PaulRB/Wemos-Weather-Station/README.md

# Wemos-Weather-Station
Outdoor Weather Station with Wind Speed, direction & Rainfall sensors
UPDATE: now with Lux/light level sensor
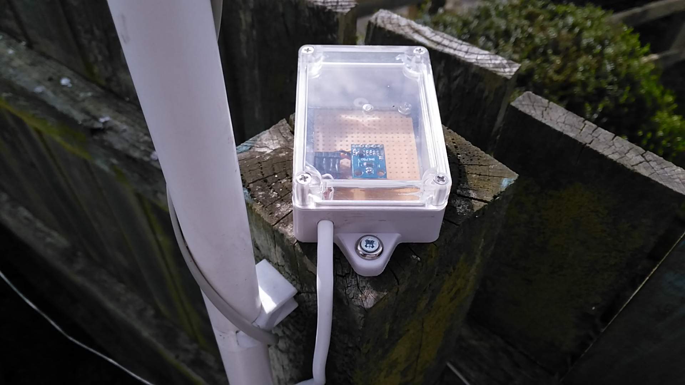
[picture p1: IMG_20170402_141529.jpg]

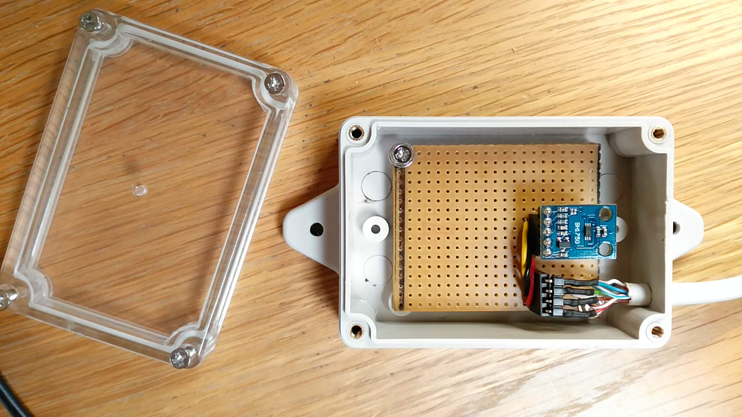
[picture p2: IMG_20170402_122711.jpg]

UPDATE: now with Wemos Mini Pro + external antenna
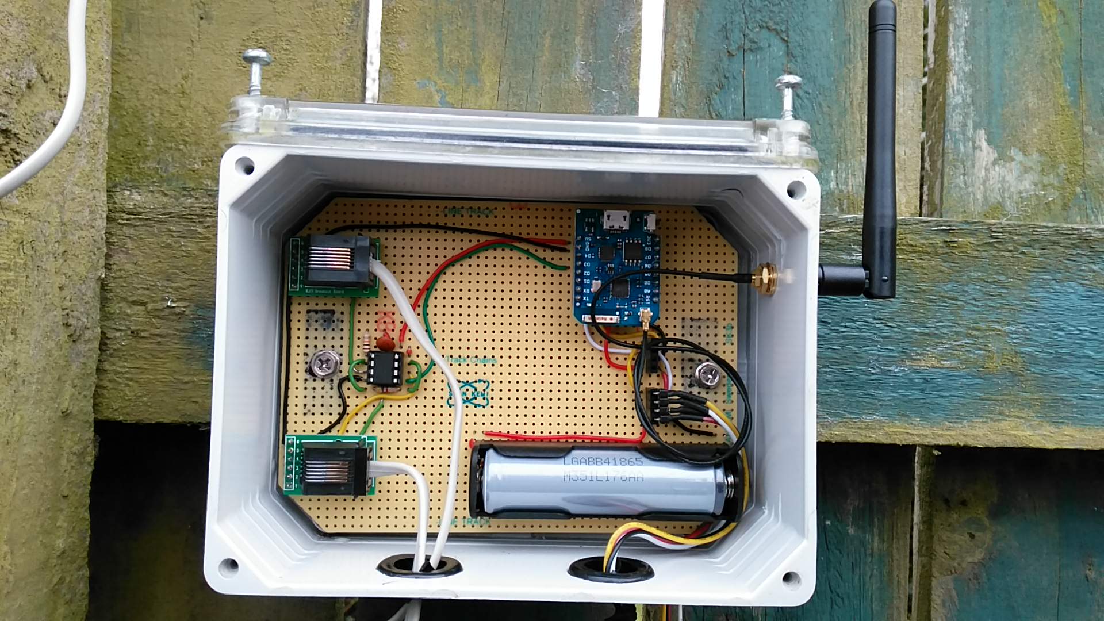
[picture p3: IMG_20170226_153004.jpg]

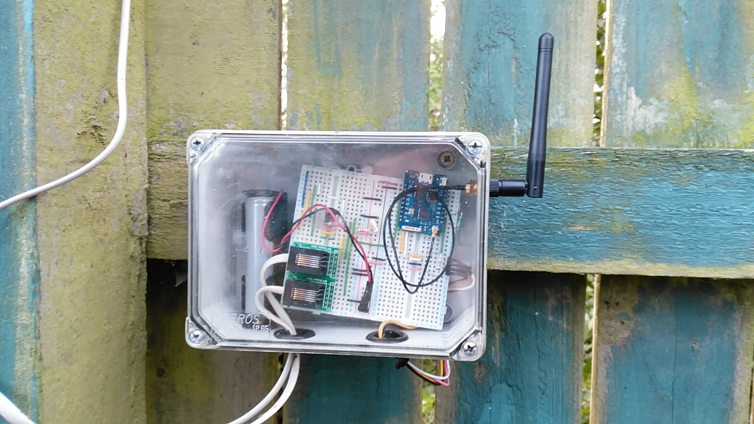
[picture p4: IMG_20161112_151442.jpg]

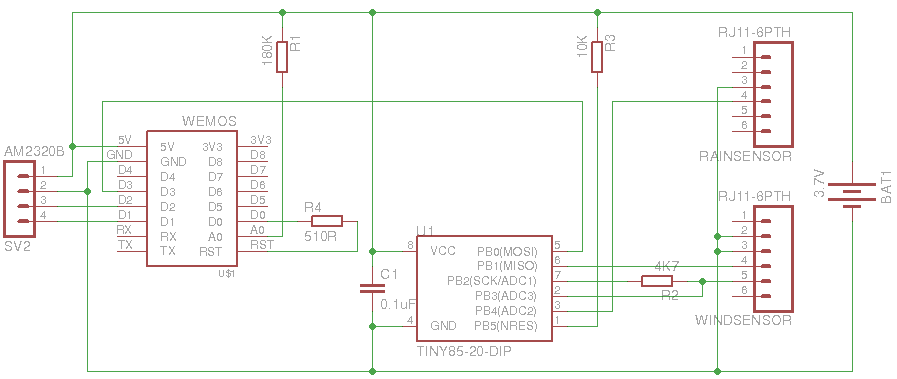
[picture p5: OutdoorSensorV3.png]

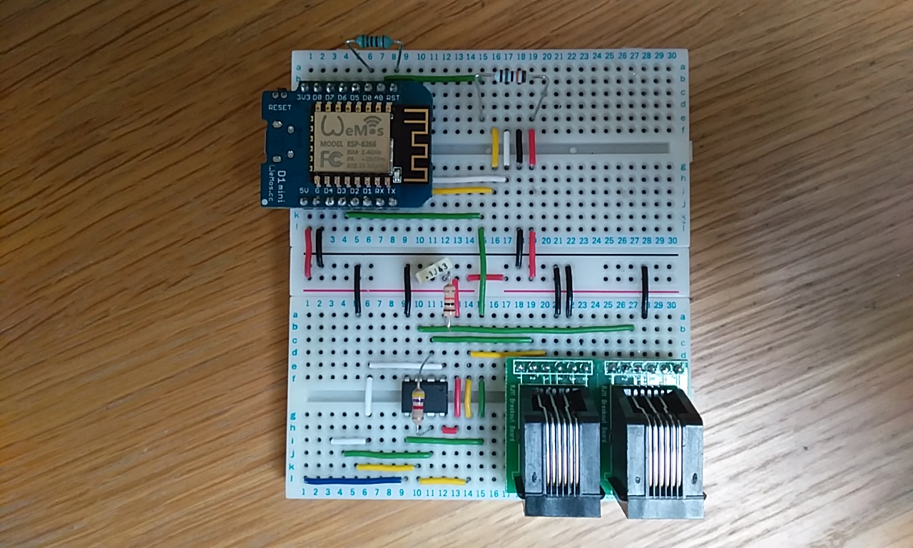
[picture p6: IMG_20160711_180757.jpg]

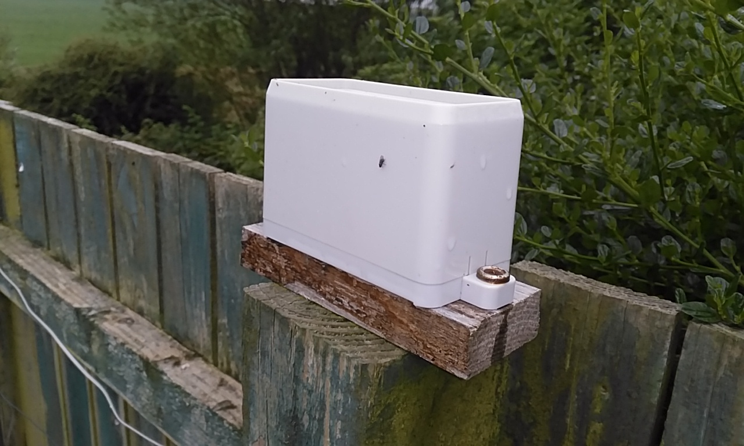
[picture p7: IMG_20160827_164953.jpg]

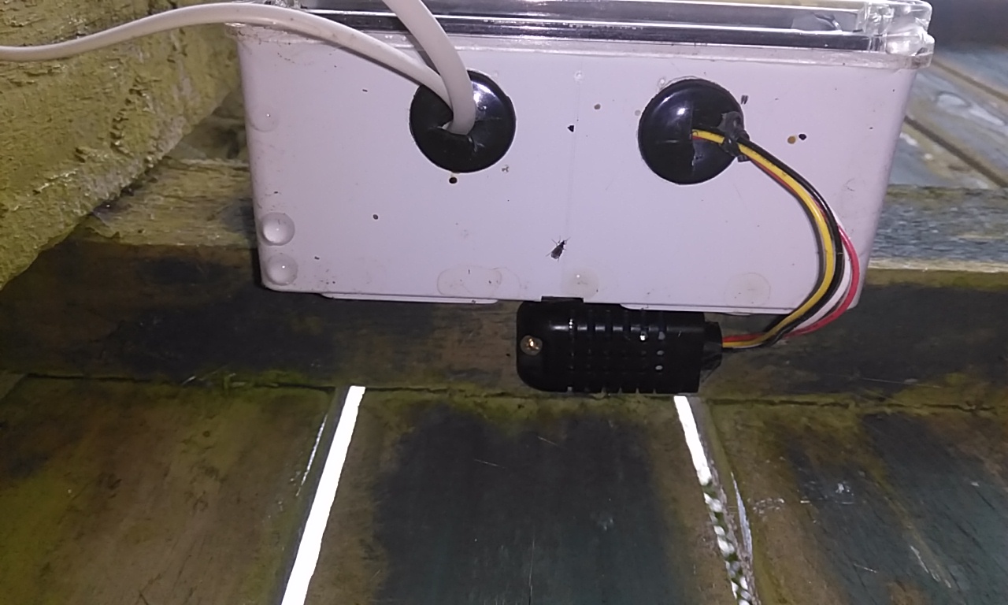
[picture p8: IMG_20160827_165017.jpg]

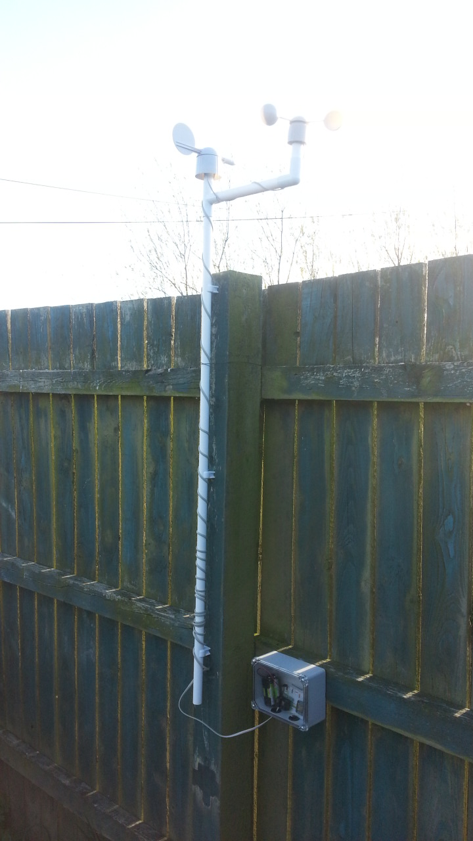
[picture p9: 20160430_181712.jpg]

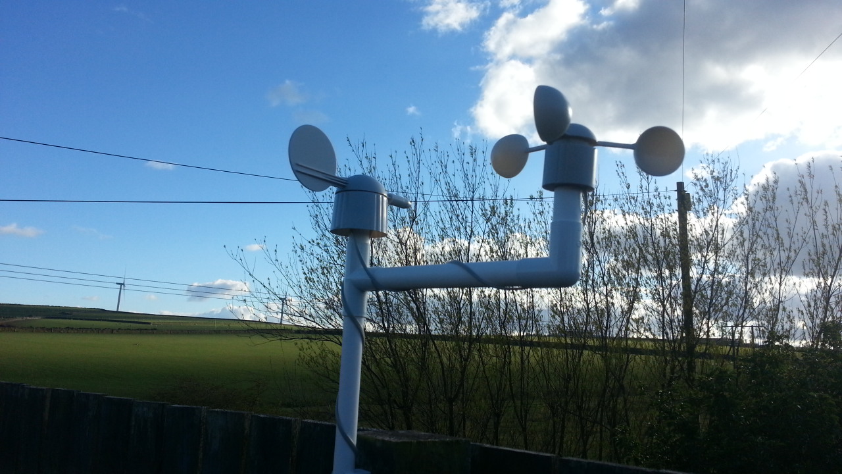
[picture p10: 20160430_181659.jpg]
