PaulRB/Wemos-Weather-Station/IMG_20160827_165125.jpg

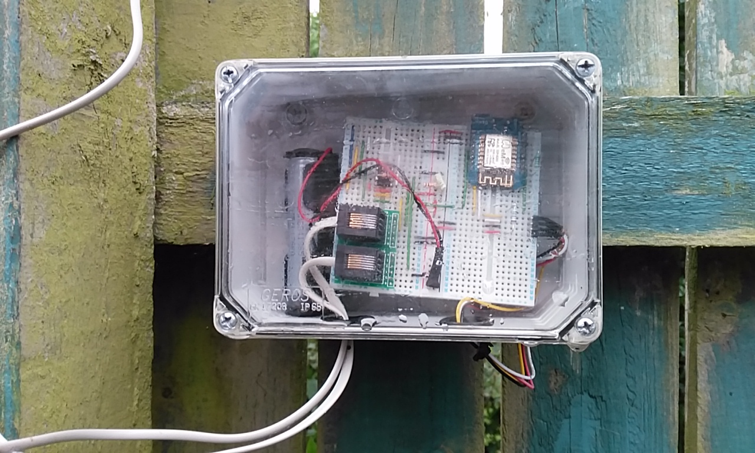
IMG_20160827_165125.jpg
