PaulRB/Wemos-Weather-Station/(threads)

Thread 2 (2018-08-12):

Question about voltage measurement

beicnet, 2018-08-12:
What is it represents?

`double battLevelNow = analogRead(BATT_LEVEL) / 209.66; // assumes external 180K resistor`

**`209.66`** Measured resistor value by multimeter or?

PaulRB, 2018-09-01:
It's a value calculated to give a known output voltage in the above formula, compared to my (inexpensive) multimeter. You can adjust the value for you own circuit if required.

beicnet, 2018-09-01:
Okay @PaulRB so how did you calculate it and by what formula any explanation?!

Thank you

PaulRB, 2018-09-01:
I calculated it with basic School maths!

Connect a voltage to the analog pin (via the 180K resistor). Measure that voltage with your multimeter, let's say that's 3.27V for example. Take the raw analogRead() value, let's say that's 686. Divide one by the other, you get 209.66.

Closed 2018-12-12.

Thread 3 (2020-04-24):

Max freq/speed of anemometer pulse detector?

colwilliamsnz, 2020-04-24:
Hi Paul, I have implemented a station using your ideas around the ATTiny85 slave device and found that the maximum anemometer frequency that can be decoded in my prototype is ~25Hz (roughly 90kph, tested using a signal generator). I wonder if you ran into this limitation at all? Struggling to make sense of it.

If I remove the sleep code I can decode beyond 60hz just fine. The current draw is 200~300uA extra in this mode so its not a huge deal, more a curiosity :)

Any clues or insight?

Thanks for sharing, its a great little project that has keep my mind nicely occupied during lockdown ;)

PaulRB, 2020-05-11:
Hi, sorry for the delay in replying!

I never tested it to that extent. I estimated that it should be able to deal with higher frequencies than that. I have never noticed the readings maxing out in practice, either on average or max gust speeds. I live in a windy place, but 90Kph is rare (thank goodness), so it could be under-reading without me realising its happening. I don't even know for sure if my cheap plastic anemometer can deal with those speeds.

Plus, where my anemometer is sited, my neighbour's bushes have grown significantly over the last 2 or 3 years and are now shadowing the sensor. I need to move it, but the only other sites are so far from the house that the WiFi won't reach.

Because of this, I am re-designing the circuit. The replacement will be an atmega328 and will use an rfm95 LoRa transmitter. This should enable me to get much greater range and lower battery consumption. The prototype is powered by 3 x AAA NiMh cells and draws 15uA when not transmitting, and even when transmitting, far lower current than WiFi. I have not implemented wind direction or rain sensing for the prototype yet, so that current may go up a little.

I don't have a signal generator to test with, but I can soon rig up an Arduino Nano or something to generate test signals for the new circuit. I estimate max frequency of 50Hz should cover the highest winds we see here.

colwilliamsnz, 2020-05-11:
Thanks for the update. I found the issue to be because I’d refactored the code so much (I switched it to I2C instead of serial because I couldn’t get the single wire serial working) and had the anemometer sensor bit way down in the loop…moving back to the top gets it to 60Hz+ which is plenty (I live in New Zealand windiest city but we'll fly off the hill if it gets to that ;)

It’s an inspired little idea that I’d keen to push further. I started out playing with LoRa and then discovered ESP32 and decided an all in one approach was best…power consumption its still the beast to tame and I’m thinking about starting the quest again just to see if I can eek out some more savings but using your overall slave approach for wind & rain.

Thanks again for inspiring!

PaulRB, 2020-05-12:
> I switched it to I2C instead of serial because I couldn’t get the single wire serial working
It took me a long time to get it working. Guess what? I switched to serial when I couldn't get i2c to work! That was my original plan, but I had problems with the master & slave getting out of sync, corrupting the data. This didn't happen immediately but occurred from a few minutes to several hours after startup, so was difficult to debug. I looked into using 1-wire Comms also (as used by ds18b20 sensors for example) but failed to get that working either, so invented my own crude "1-wire" method!
> It’s an inspired little idea that I’d keen to push further.
I always advise beginners to avoid multiple MCU in the same circuit, but broke my own rule that time. In the new design, the atmega328 uses considerably less power than the attiny85 does in the current design, and there is no esp chip to run either.
> Thanks again for inspiring!
Thanks for the encouragement. I must get back to working on it. Working from home during lockdown means I often don't feel like spending more time at my desk working on hobby stuff.

We hear NZ has made a much better job of dealing with CV19 pandemic than UK!

Closed 2020-05-11.

Thread 4 (2021-03-29):

one pin communication

MrSteffenME, 2021-03-29:
hi, I've been running D1s for almost 3 years but with a lack of analog pins, your project is exactly what I needed! I recreated your whole project but the only issue is I can't get any communication protocol running between d1 pro and attiny85, I need to run the one-pin comms because my attiny pins are now full.  can you assist me into this, please

PaulRB, 2021-03-29:
Hi, are you using the code and schematic exactly as shown in this repo, or are you wanting to make some changes or adaptations?

MrSteffenME, 2021-03-29:
I have similar sensors connected but that's on the d1 directly.  The issue is with the attiny comms, that part is exactly the same but with the line: SoftwareSerial slaveMCU(SLAVE_RX, SLAVE_TX, false, 64); mine is just SoftwareSerial slaveMCU(SLAVE_RX, SLAVE_TX), with yours it freaks out with the last two params:

1.1Master:19:54: error: no matching function for call to 'SoftwareSerial::SoftwareSerial(int, int, bool, int)'
 SoftwareSerial slaveMCU(SLAVE_RX, SLAVE_TX, false, 64);
                                                      ^
D:\NGA\Arduino\WeatherStation\Master\1.1Master\1.1Master.ino:19:54: note: candidates are:
In file included from D:\NGA\Arduino\WeatherStation\Master\1.1Master\1.1Master.ino:10:0:
C:\Users\Steffen\AppData\Local\Arduino15\packages\esp8266\hardware\esp8266\2.7.4\libraries\SoftwareSerial\src/SoftwareSerial.h:93:5: note: SoftwareSerial::SoftwareSerial(int8_t, int8_t, bool)
     SoftwareSerial(int8_t rxPin, int8_t txPin = -1, bool invert = false);
     ^
C:\Users\Steffen\AppData\Local\Arduino15\packages\esp8266\hardware\esp8266\2.7.4\libraries\SoftwareSerial\src/SoftwareSerial.h:93:5: note:   candidate expects 3 arguments, 4 provided
C:\Users\Steffen\AppData\Local\Arduino15\packages\esp8266\hardware\esp8266\2.7.4\libraries\SoftwareSerial\src/SoftwareSerial.h:89:5: note: SoftwareSerial::SoftwareSerial()
     SoftwareSerial();
     ^
C:\Users\Steffen\AppData\Local\Arduino15\packages\esp8266\hardware\esp8266\2.7.4\libraries\SoftwareSerial\src/SoftwareSerial.h:89:5: note:   candidate expects 0 arguments, 4 provided
Multiple libraries were found for "SoftwareSerial.h"
 Used: C:\Users\Steffen\AppData\Local\Arduino15\packages\esp8266\hardware\esp8266\2.7.4\libraries\SoftwareSerial
 Not used: E:\Documents\Arduino\libraries\espsoftwareserial-master
exit status 1
no matching function for call to 'SoftwareSerial::SoftwareSerial(int, int, bool, int)'

this is with my esp8266 library.  but I cant think that is whats the issue?

PaulRB, 2021-03-29:
Looks like that library has changed since I last used it. No longer accepts 4 parameters, only 3. I think that last parameter is buffer size, which seems to default to 64 in latest version, so try removing that.

MrSteffenME, 2021-03-29:
I did and I used software serial with both pins in other devices, so I don't think it's that, maybe it can be. I am busy with this the last 5 days.   I change the attiny to only an output, to send a byte every 1000 and the d1 to input. only testing the comms, but that is not even working.  I also changed the pin from #define SERIAL_OUT 0 to #define SERIAL_OUT PB0, but still nothing.  I tried to send a command to attiny switching a pin on, nothing. I tested 2 attiny with blink sketches that worked 100%.  looks like a long night for me

PaulRB, 2021-03-30:
Why are you using attiny85?

I used one in this project because my windspeed, direction and rain sensors are "dumb" and need continuous monitoring: counting pulses etc. If I used the Wemos to monitor the sensors directly, I could not reduce the current to below around 20mA, which would have drastically reduced the battery life. The tiny85 can monitor the sensors using only about 0.5mA. I did not use the tiny85 only to provide extra digital or analog pins, if that was my only requirement I would have used i2c chips/modules for that, which would not require an extra sketch to be uploaded to them, and would avoid the difficulties that come with getting two MCU to communicate. Getting this to work was difficult and took time and frustration, and you are discovering the same.
